tonic2s/saiga/README.md

# Saiga Keyboard

Saiga Logo

A line of mechanical keyboards.
- [Prototyping Board](prototyping-board/README.md)
- [Keypad / Numpad](keypad/README.md)
