tonic2s/saiga/keypad/README.md

# Saiga Keypad

A mechanical keypad.

## Features
- ISO keypad
- 17 mechanical switches
- 2 rotary encoder
- 3 plate mounted stabilizer
- Single color backlight
- RGB LED for each key
- Raspberry Pico as micro controler solderd on to the PCB
- [Driver in Circuit Python](driver/README.md)
