tonic2s/saiga/prototyping-board/README.md

# Saiga Protyping Board

A small makro keyboard.

## Features
- 3x5 mechanical switches
- Row wise single color backlight
- Five RGB LED's
- Pin breakout for use on a breadboard
- Raspberry Pico as micro controler
- [Driver in Circuit Python](driver/README.md)
