tonic2s/saiga/keypad/hardware/Case/Keypad Case.obj

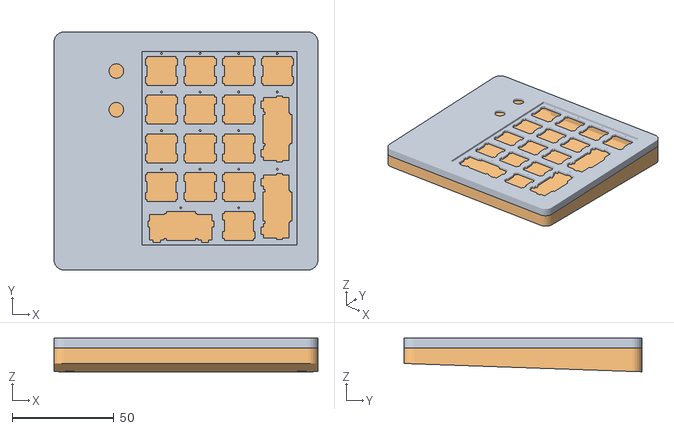
[picture p1: CAD file, 2022-02-27]
keypad/hardware/Case/Keypad Case.obj
130.0 x 117.3 x 16.6
Deckel
Boden
