tonic2s/saiga/keypad/hardware/Case/Case Top.stl

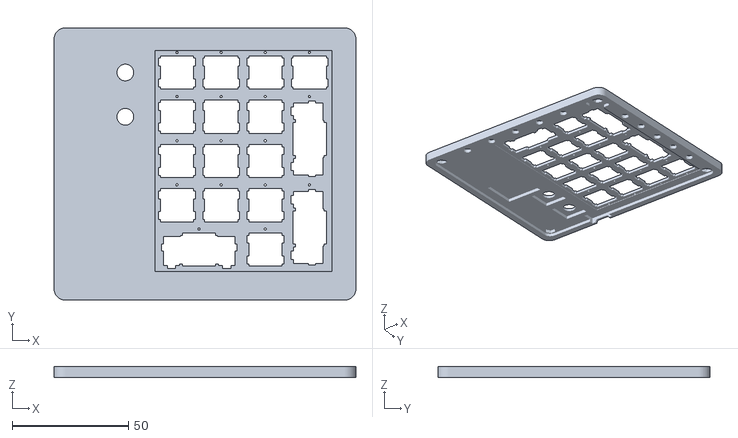
[picture p2: CAD file, 2022-02-27]
keypad/hardware/Case/Case Top.stl
130.0 x 117.3 x 4.90
