tonic2s/saiga/keypad/hardware/Case/Case Bottom.stl

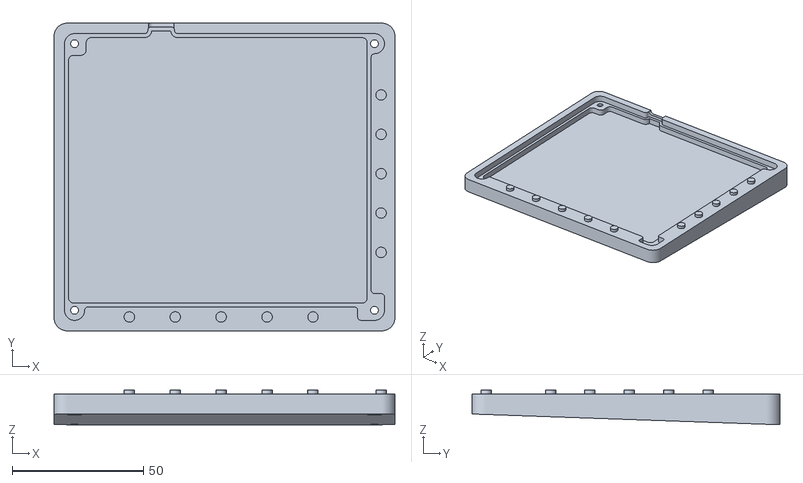
[picture p3: CAD file, 2022-02-27]
keypad/hardware/Case/Case Bottom.stl
130.0 x 117.3 x 13.1
