tonic2s/saiga/keypad/hardware/PCB/Saiga_Kepad.kicad_pcb

## KiCad design keypad/hardware/PCB/Saiga_Kepad.kicad_pcb (2022-02-19)

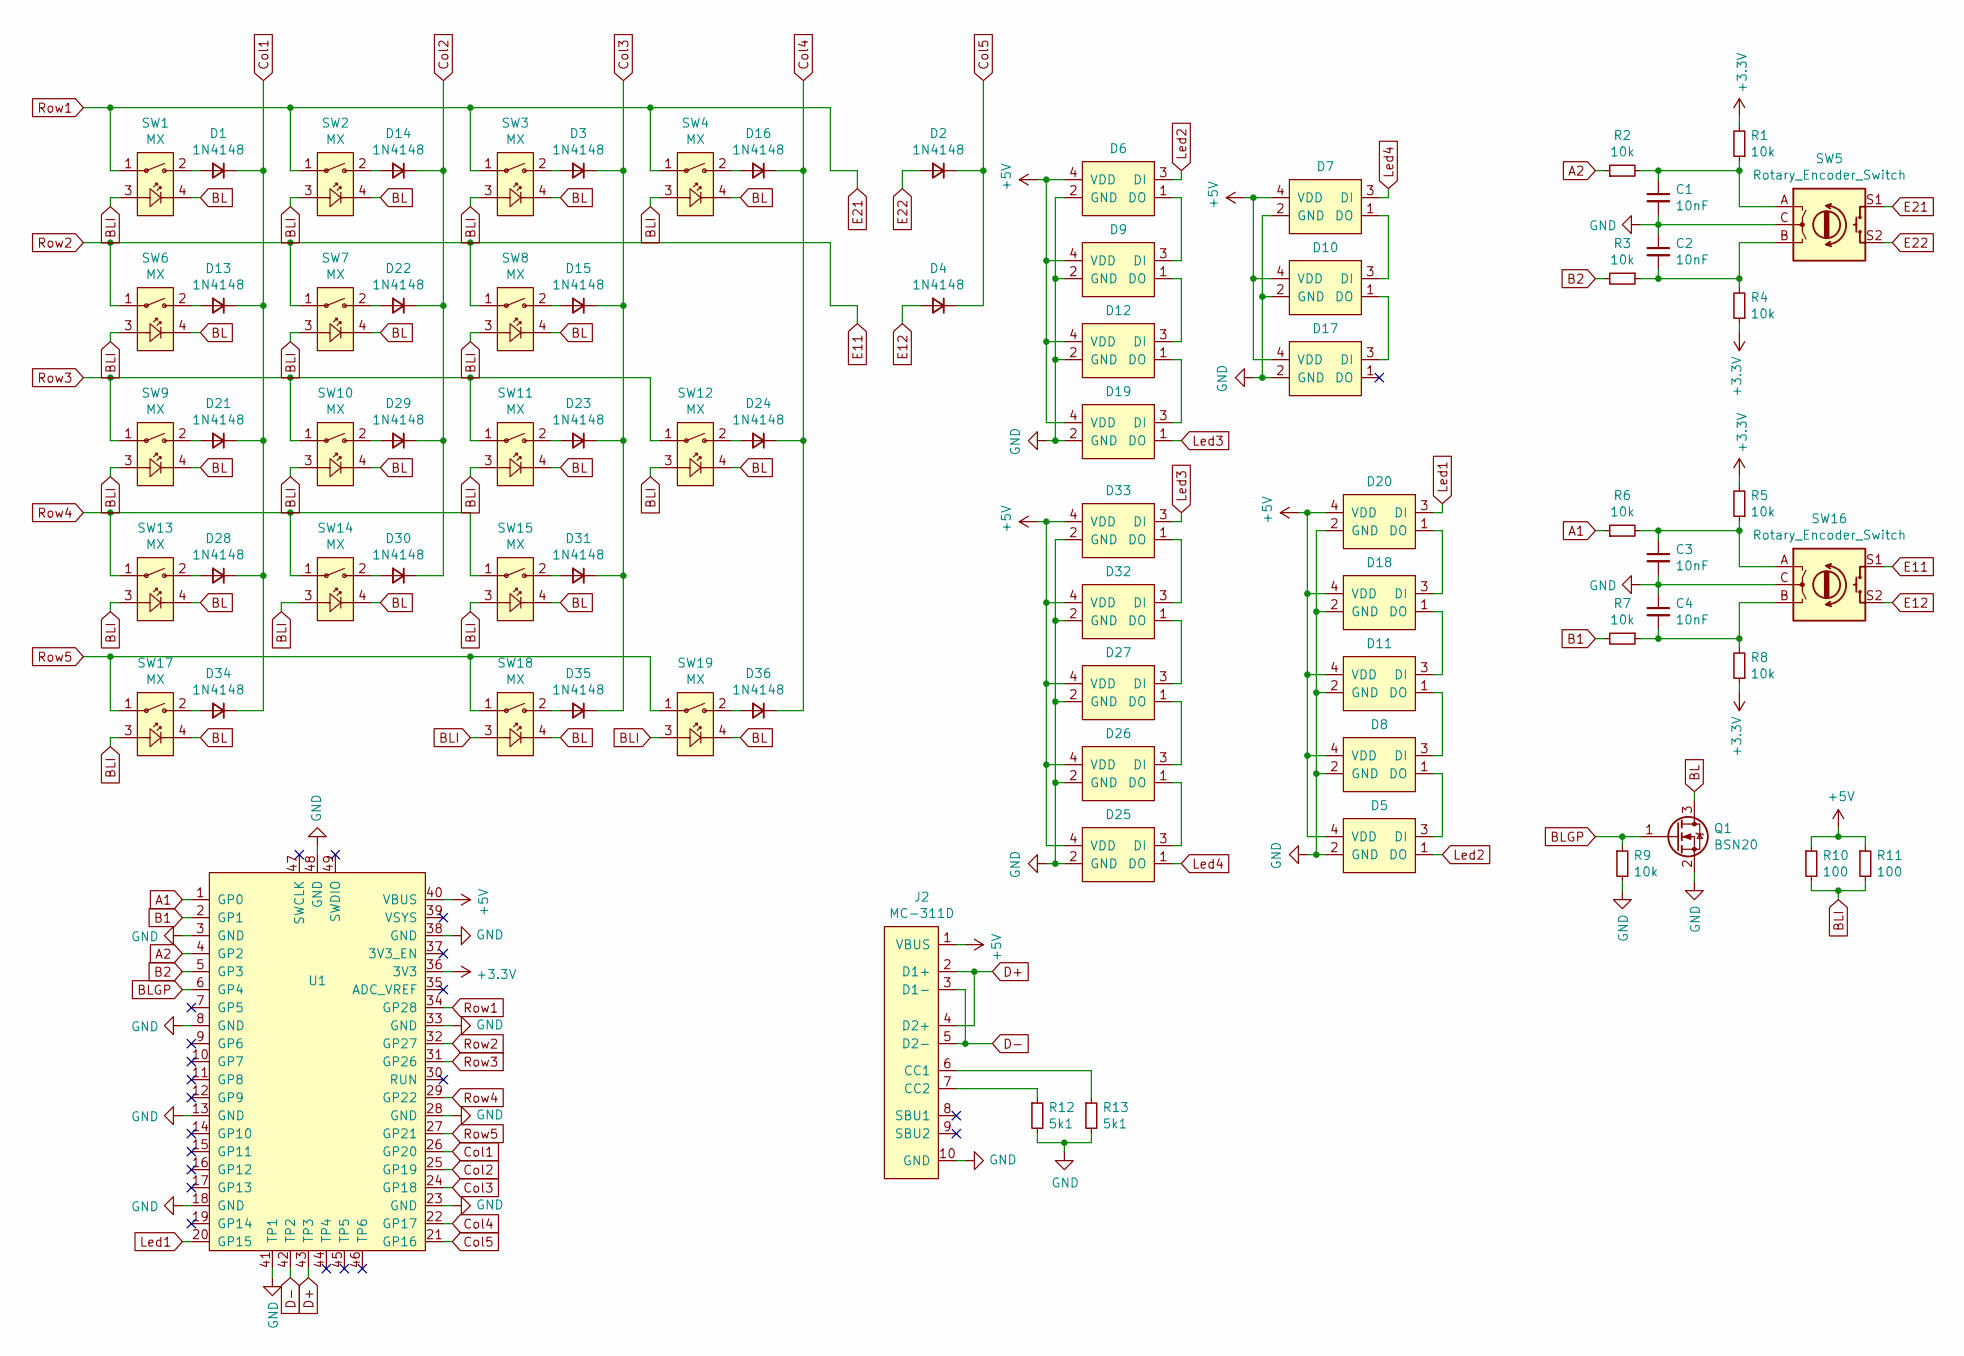
[picture p4: schematic Saiga_Keypad.kicad_sch, Saiga Keypad]

Parts:
C1, C2, C3, C4: 10nF; C_0805_2012Metric_Pad1.18x1.45mm_HandSolder
D1, D2, D3, D4, D13, D14, D15, D16, D21, D22, D23, D24, D28, D29, D30, D31, D34, D35, D36: 1N4148; D_SOD-123
D5, D6, D7, D8, D9, D10, D11, D12, D17, D18, D19, D20, D25, D26, D27, D32, D33: WS2812B-2020
J2: MC-311D
Q1: BSN20; SOT-23
R1, R2, R3, R4, R5, R6, R7, R8, R9: 10k; R_0805_2012Metric_Pad1.20x1.40mm_HandSolder
R10, R11: 100; R_2512_6332Metric_Pad1.40x3.35mm_HandSolder
R12, R13: 5k1; R_0805_2012Metric_Pad1.20x1.40mm_HandSolder
SW1, SW2, SW3, SW4, SW6, SW7, SW8, SW9, SW10, SW11, SW12, SW13, SW14, SW15, SW17, SW18, SW19: MX; Cherry_MX_5_Led
SW5, SW16: Rotary_Encoder_Switch; RotaryEncoder_Alps_EC12E-Switch_Vertical_H20mm_CircularMoun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
U1: RP2040_Pico; RP Pico

Connections:
+3V3: R1.2, R4.1, R5.2, R8.1, U1.36 (3V3)
+5V: D5.4 (VDD), D6.4 (VDD), D7.4 (VDD), D8.4 (VDD), D9.4 (VDD), D10.4 (VDD), D11.4 (VDD), D12.4 (VDD), D17.4 (VDD), D18.4 (VDD), D19.4 (VDD), D20.4 (VDD), D25.4 (VDD), D26.4 (VDD), D27.4 (VDD), D32.4 (VDD), D33.4 (VDD), J2.1 (VBUS), R10.1, R11.1, U1.40 (VBUS)
A1: R6.1, U1.1 (GP0)
A2: R2.1, U1.4 (GP2)
B1: R7.2, U1.2 (GP1)
B2: R3.2, U1.5 (GP3)
BL: Q1.3 (D), SW1.4, SW2.4, SW3.4, SW4.4, SW6.4, SW7.4, SW8.4, SW9.4, SW10.4, SW11.4, SW12.4, SW13.4, SW14.4, SW15.4, SW17.4, SW18.4, SW19.4
BLGP: Q1.1 (G), R9.1, U1.6 (GP4)
BLI: R10.2, R11.2, SW1.3, SW2.3, SW3.3, SW4.3, SW6.3, SW7.3, SW8.3, SW9.3, SW10.3, SW11.3, SW12.3, SW13.3, SW14.3, SW15.3, SW17.3, SW18.3, SW19.3
Col1: D1.1 (K), D13.1 (K), D21.1 (K), D28.1 (K), D34.1 (K), U1.26 (GP20)
Col2: D14.1 (K), D22.1 (K), D29.1 (K), D30.1 (K), U1.25 (GP19)
Col3: D3.1 (K), D15.1 (K), D23.1 (K), D31.1 (K), D35.1 (K), U1.24 (GP18)
Col4: D16.1 (K), D24.1 (K), D36.1 (K), U1.22 (GP17)
Col5: D2.1 (K), D4.1 (K), U1.21 (GP16)
D+: J2.2 (D1+), J2.4 (D2+), U1.43 (TP3)
D-: J2.3 (D1-), J2.5 (D2-), U1.42 (TP2)
E11: SW6.1, SW7.1, SW8.1, SW16.S1, U1.32 (GP27)
E12: D4.2 (A), SW16.S2
E21: SW1.1, SW2.1, SW3.1, SW4.1, SW5.S1, U1.34 (GP28)
E22: D2.2 (A), SW5.S2
GND: C1.2, C2.1, C3.2, C4.1, D5.2 (GND), D6.2 (GND), D7.2 (GND), D8.2 (GND), D9.2 (GND), D10.2 (GND), D11.2 (GND), D12.2 (GND), D17.2 (GND), D18.2 (GND), D19.2 (GND), D20.2 (GND), D25.2 (GND), D26.2 (GND), D27.2 (GND), D32.2 (GND), D33.2 (GND), J2.10 (GND), Q1.2 (S), R9.2, R12.2, R13.2, SW5.C, SW16.C, U1.3 (GND), U1.8 (GND), U1.13 (GND), U1.18 (GND), U1.23 (GND), U1.28 (GND), U1.33 (GND), U1.38 (GND), U1.41 (TP1), U1.48 (GND)
Led1: D20.3 (DI), U1.20 (GP15)
Led2: D5.1 (DO), D6.3 (DI)
Led3: D19.1 (DO), D33.3 (DI)
Led4: D7.3 (DI), D25.1 (DO)
unnamed: C1.1, R1.1, R2.2, SW5.A
unnamed: C2.2, R3.1, R4.2, SW5.B
unnamed: C3.1, R5.1, R6.2, SW16.A
unnamed: C4.2, R7.1, R8.2, SW16.B
unnamed: D1.2 (A), SW1.2
unnamed: D3.2 (A), SW3.2
unnamed: D5.3 (DI), D8.1 (DO)
unnamed: D6.1 (DO), D9.3 (DI)
unnamed: D10.1 (DO), D17.3 (DI)
unnamed: D7.1 (DO), D10.3 (DI)
unnamed: D8.3 (DI), D11.1 (DO)
unnamed: D11.3 (DI), D18.1 (DO)
unnamed: D12.1 (DO), D19.3 (DI)
unnamed: D9.1 (DO), D12.3 (DI)
unnamed: D13.2 (A), SW6.2
unnamed: D14.2 (A), SW2.2
unnamed: D15.2 (A), SW8.2
unnamed: D16.2 (A), SW4.2
unnamed: D18.3 (DI), D20.1 (DO)
unnamed: D21.2 (A), SW9.2
unnamed: D22.2 (A), SW7.2
unnamed: D23.2 (A), SW11.2
unnamed: D24.2 (A), SW12.2
unnamed: D25.3 (DI), D26.1 (DO)
unnamed: D26.3 (DI), D27.1 (DO)
unnamed: D27.3 (DI), D32.1 (DO)
unnamed: D28.2 (A), SW13.2
unnamed: D29.2 (A), SW10.2
unnamed: D30.2 (A), SW14.2
unnamed: D31.2 (A), SW15.2
unnamed: D32.3 (DI), D33.1 (DO)
unnamed: D34.2 (A), SW17.2
unnamed: D35.2 (A), SW18.2
unnamed: D36.2 (A), SW19.2
unnamed: J2.6 (CC1), R13.1
unnamed: J2.7 (CC2), R12.1
Row3: SW9.1, SW10.1, SW11.1, SW12.1, U1.31 (GP26)
Row4: SW13.1, SW14.1, SW15.1, U1.29 (GP22)
Row5: SW17.1, SW18.1, SW19.1, U1.27 (GP21)

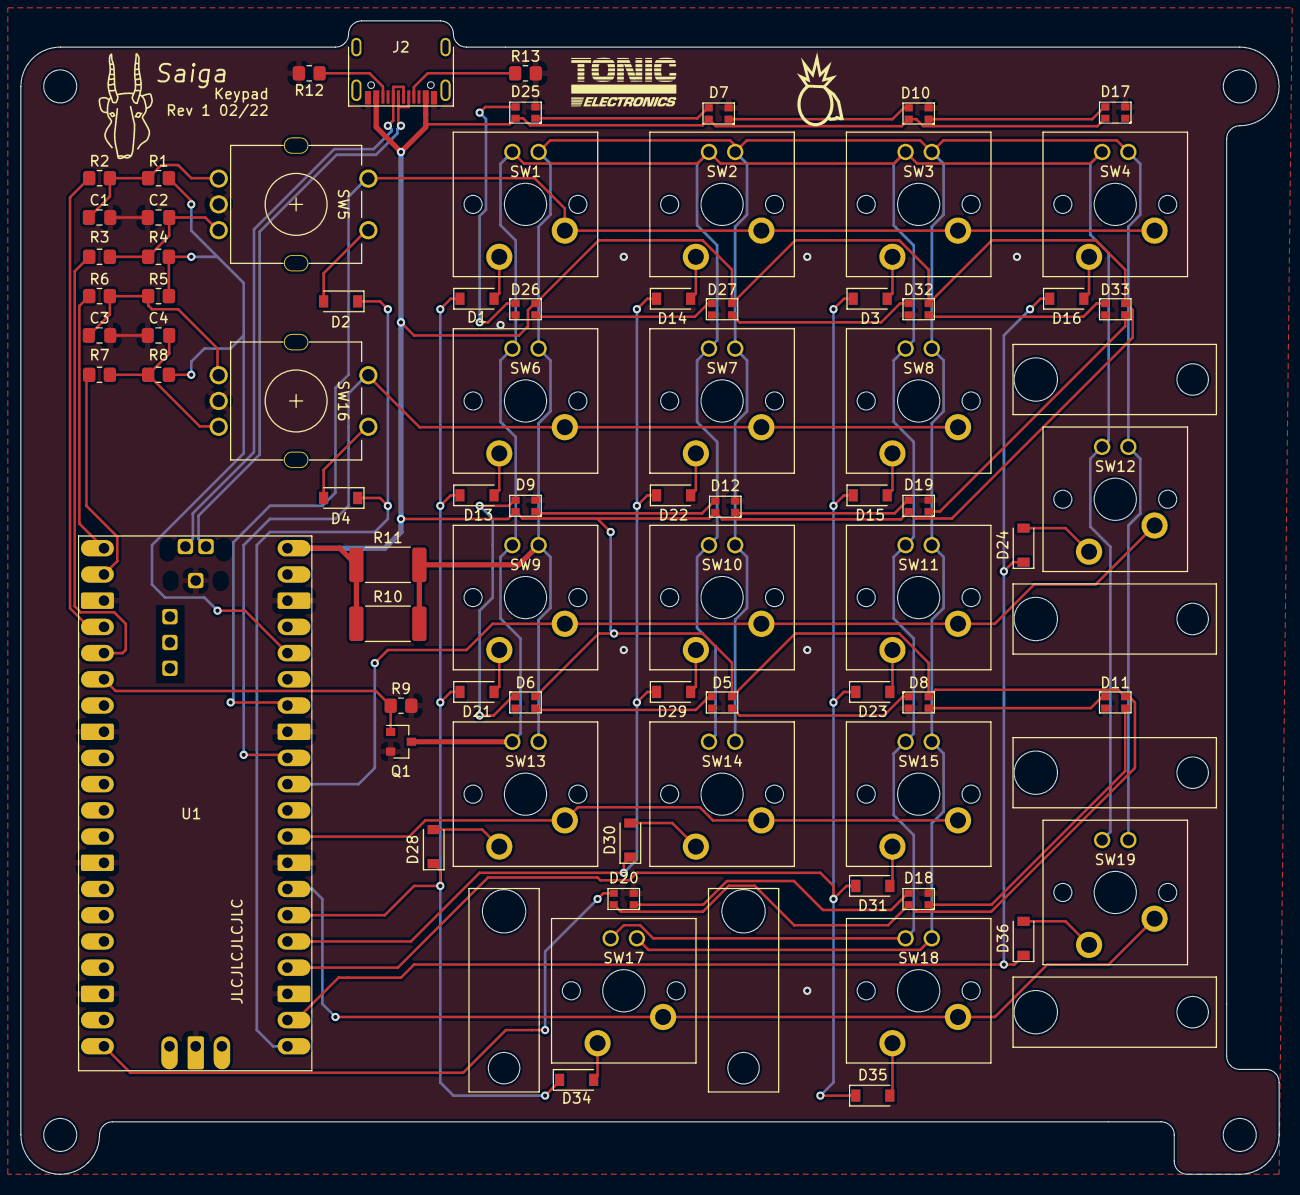
[picture p5: board Saiga_Kepad.kicad_pcb from above]

Board: 2 copper layers, 121.9 x 111.8 mm, 75 parts (0 on the bottom side), 64 nets.
