tonic2s/saiga/(commit log)

2021-10-16 Add initial README's, logo and existing file for prototyping board
2022-02-18 WIP: Rework driver to use a scheduler for parallel processing
    [accent.py, backlight.py, config.py, keyboard.py, task.py, watchdog.py]
2022-02-19 initial upload of kicad files
    Added kicad schematic and kicad pcb
    [Saiga_Kepad.kicad_pcb, Saiga_Keypad.kicad_sch]
2022-02-19 Added gerber files
2022-02-19 Make folders lowercase, copy driver and add readme
    [Saiga_Kepad.kicad_pcb, Saiga_Keypad.kicad_sch]
2022-02-20 WIP: Update keypad driver
2022-02-23 First working keypad driver release
2022-02-25 Add message bus to the keypad driver and use async module to check keys
2022-02-27 added Case
    [Case Bottom.stl, Case Top.stl, Keypad Case.obj, Saiga_Kepad.kicad_pcb, Saiga_Keypad.kicad_sch]
2022-02-27 Switch to asyncio scheduling and make consumer only react to commands
2022-02-28 added animations, implemented pulse animation, minor bug fix with timed tasks
    [accent.py, code.py, config.py, messaging.py, pulse.py, task.py]
2022-04-25 Add support for action layer switching
2022-04-29 Add two class diagrams of the keypad driver
2022-04-29 Add rendered PlantUML diagrams to driver readme
